dexterlb/wled-i-nator/hardware/wled_controller/wled_controller.kicad_pcb

## KiCad design hardware/wled_controller/wled_controller.kicad_pcb (2024-08-14)

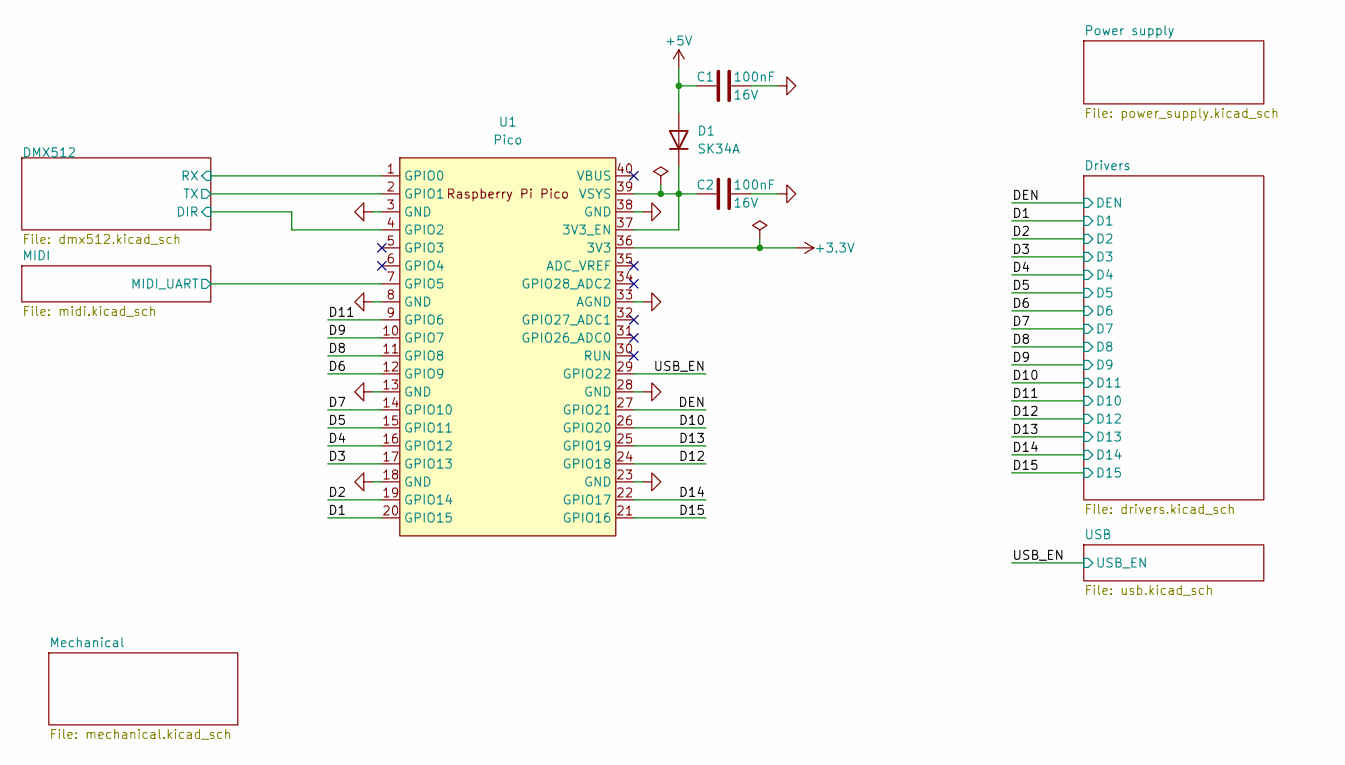
[picture p1: schematic wled_controller.kicad_sch]

Parts:
C1, C2: 100nF; C_0805_2012Metric; Part C 100nF 16V 0805
D1: SK34A; D_SMA; Part SK34A
U1: Pico; RPi_Pico_TH; Part 2x Header_01x20

Connections:
+3.3V: U1.36 (3V3); also elsewhere on the board
+5V: C1.1, D1.2 (A); also elsewhere on the board
/D1: U1.20 (GPIO15); also elsewhere on the board
/D2: U1.19 (GPIO14); also elsewhere on the board
/D3: U1.17 (GPIO13); also elsewhere on the board
/D4: U1.16 (GPIO12); also elsewhere on the board
/D5: U1.15 (GPIO11); also elsewhere on the board
/D6: U1.12 (GPIO9); also elsewhere on the board
/D7: U1.14 (GPIO10); also elsewhere on the board
/D8: U1.11 (GPIO8); also elsewhere on the board
/D9: U1.10 (GPIO7); also elsewhere on the board
/D10: U1.26 (GPIO20); also elsewhere on the board
/D11: U1.9 (GPIO6); also elsewhere on the board
/D12: U1.24 (GPIO18); also elsewhere on the board
/D13: U1.25 (GPIO19); also elsewhere on the board
/D14: U1.22 (GPIO17); also elsewhere on the board
/D15: U1.21 (GPIO16); also elsewhere on the board
/DEN: U1.27 (GPIO21); also elsewhere on the board
/DMX512/DIR: U1.4 (GPIO2); also elsewhere on the board
/DMX512/RX: U1.1 (GPIO0); also elsewhere on the board
/DMX512/TX: U1.2 (GPIO1); also elsewhere on the board
/MIDI/MIDI_UART: U1.7 (GPIO5); also elsewhere on the board
/USB_EN: U1.29 (GPIO22); also elsewhere on the board
GND: C1.2, C2.2, U1.3 (GND), U1.8 (GND), U1.13 (GND), U1.18 (GND), U1.23 (GND), U1.28 (GND), U1.33 (AGND), U1.38 (GND); also elsewhere on the board
unnamed: C2.1, D1.1 (K), U1.37 (3V3_EN), U1.39 (VSYS)

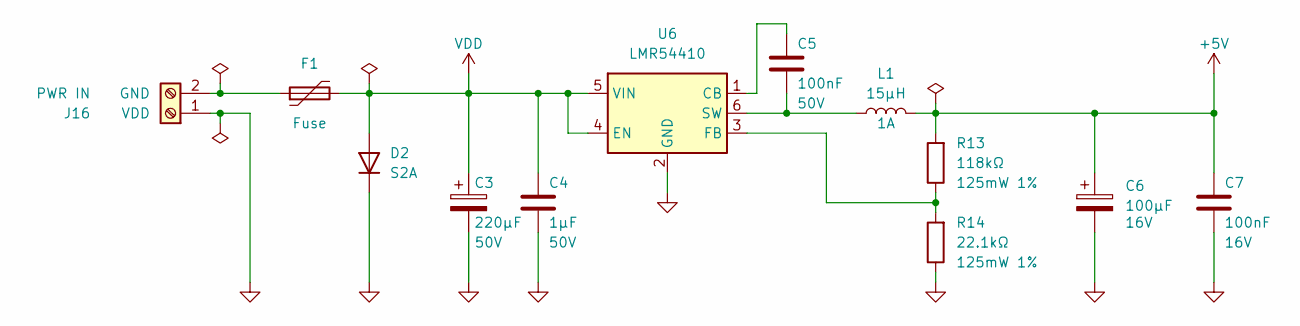
[picture p2: schematic power_supply.kicad_sch]

Parts:
C3: 220μF; CP_Radial_D10.0mm_P5.00mm; Part C 220μF 50V P5
C4: 1μF; C_0805_2012Metric; Part C 1μF 50V 0805
C5: 100nF; C_0805_2012Metric; Part C 100nF 50V 0805
C6: 100μF; CP_Radial_D5.0mm_P2.00mm; Part C 100μF 16V P2
C7: 100nF; C_0805_2012Metric; Part C 100nF 16V 0805
D2: S2A; D_SMB; Part S2A; LCSC C7420368
F1: Fuse; Fuseholder_FS002; Part 2x FS-002
J16: Screw_Terminal_01x02; TerminalBlock_1x02_P5.00mm_Horizontal; Part DG127-5.0-02P-14-00AH
L1: 15μH; L_Changjiang_FNR6045S; Part NRS6045T150MMGK
R13: 118kΩ; R_0805_2012Metric; Part R 118kΩ 125mW 1% 0805
R14: 22.1kΩ; R_0805_2012Metric; Part R 22.1kΩ 125mW 1% 0805
U6: LMR54410; SOT-23-6; Part LMR54410FDBVR

Connections:
+5V: C6.1, C7.1, L1.2, R13.2; also elsewhere on the board
GND: C3.2, C4.2, C6.2, C7.2, D2.1 (K), J16.1, R14.1, U6.2 (GND); also elsewhere on the board
unnamed: F1.1, J16.2
unnamed: C5.1, U6.1 (CB)
unnamed: R13.1, R14.2, U6.3 (FB)
unnamed: C5.2, L1.1, U6.6 (SW)
VDD: C3.1, C4.1, D2.2 (A), F1.2, U6.4 (EN), U6.5 (VIN); also elsewhere on the board

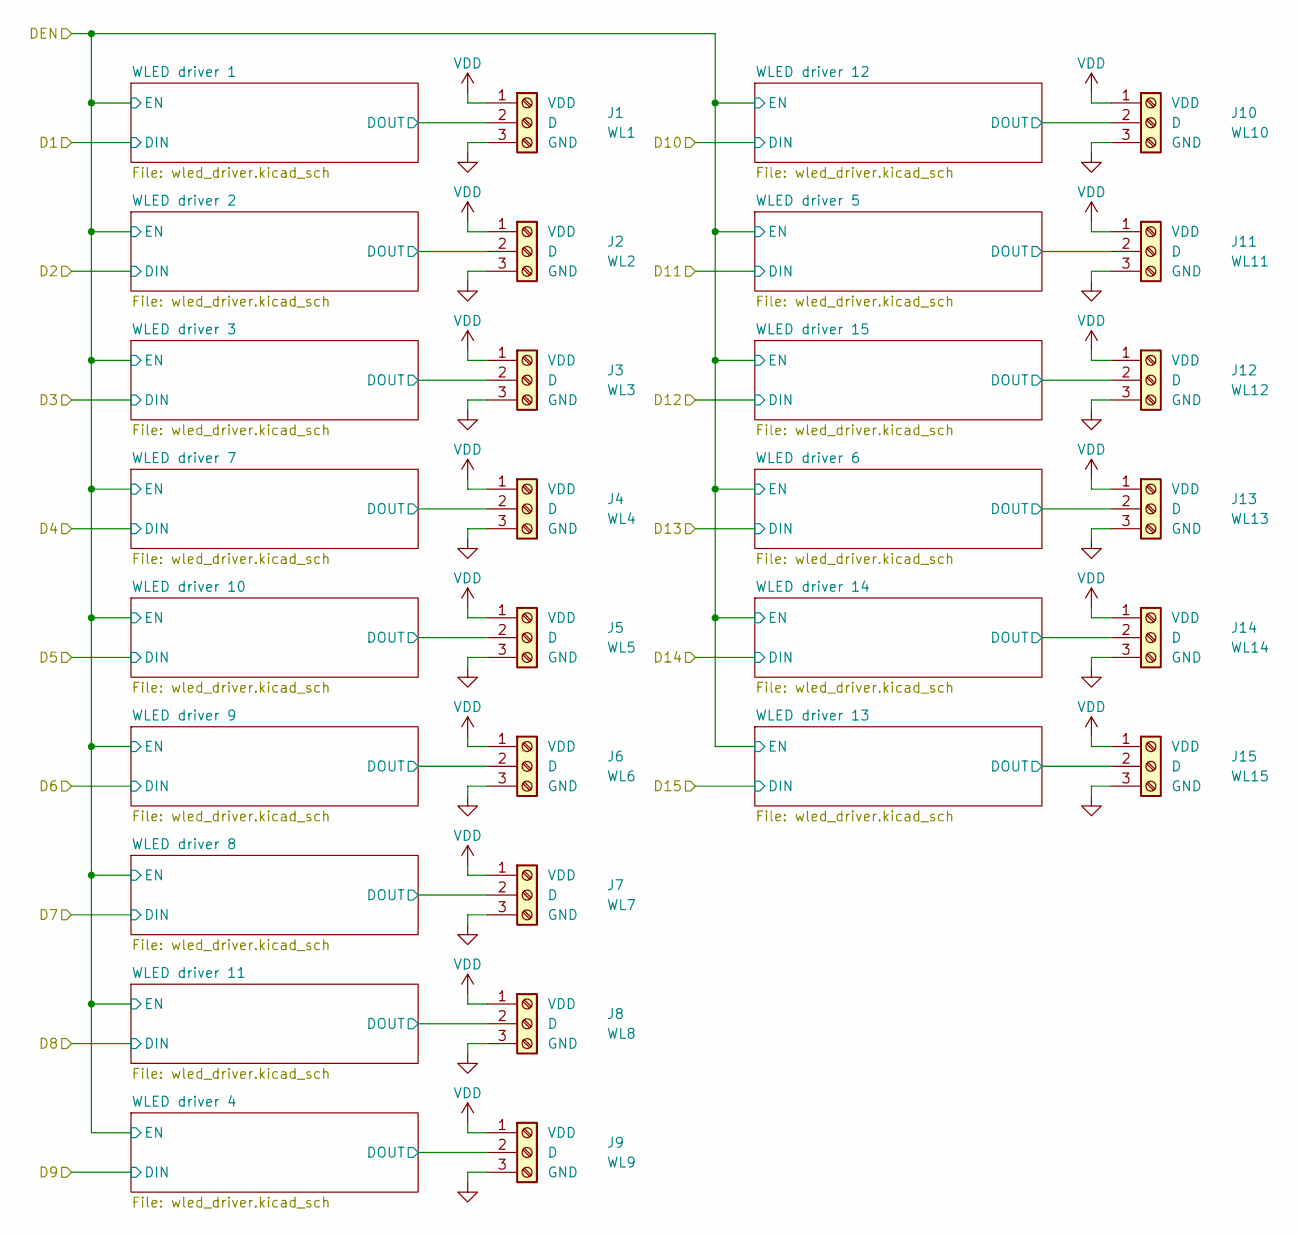
[picture p3: schematic drivers.kicad_sch]

Parts:
J1, J2, J3, J4, J5, J6, J7, J8, J9, J10, J11, J12, J13, J14, J15: Screw_Terminal_01x03; TerminalBlock_Degson_1x03_P3.50mm_Horizontal; Part 15EDGRC-3.5-03P-14-00AH, 15EDGK-3.5-03P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

Connections:
/Drivers/WLED driver 1/DOUT: J1.2; also elsewhere on the board
/Drivers/WLED driver 2/DOUT: J2.2; also elsewhere on the board
/Drivers/WLED driver 3/DOUT: J3.2; also elsewhere on the board
/Drivers/WLED driver 4/DOUT: J9.2; also elsewhere on the board
/Drivers/WLED driver 5/DOUT: J11.2; also elsewhere on the board
/Drivers/WLED driver 6/DOUT: J13.2; also elsewhere on the board
/Drivers/WLED driver 7/DOUT: J4.2; also elsewhere on the board
/Drivers/WLED driver 8/DOUT: J7.2; also elsewhere on the board
/Drivers/WLED driver 9/DOUT: J6.2; also elsewhere on the board
/Drivers/WLED driver 10/DOUT: J5.2; also elsewhere on the board
/Drivers/WLED driver 11/DOUT: J8.2; also elsewhere on the board
/Drivers/WLED driver 12/DOUT: J10.2; also elsewhere on the board
/Drivers/WLED driver 13/DOUT: J15.2; also elsewhere on the board
/Drivers/WLED driver 14/DOUT: J14.2; also elsewhere on the board
/Drivers/WLED driver 15/DOUT: J12.2; also elsewhere on the board
GND: J1.3, J2.3, J3.3, J4.3, J5.3, J6.3, J7.3, J8.3, J9.3, J10.3, J11.3, J12.3, J13.3, J14.3, J15.3; also elsewhere on the board
VDD: J1.1, J2.1, J3.1, J4.1, J5.1, J6.1, J7.1, J8.1, J9.1, J10.1, J11.1, J12.1, J13.1, J14.1, J15.1; also elsewhere on the board

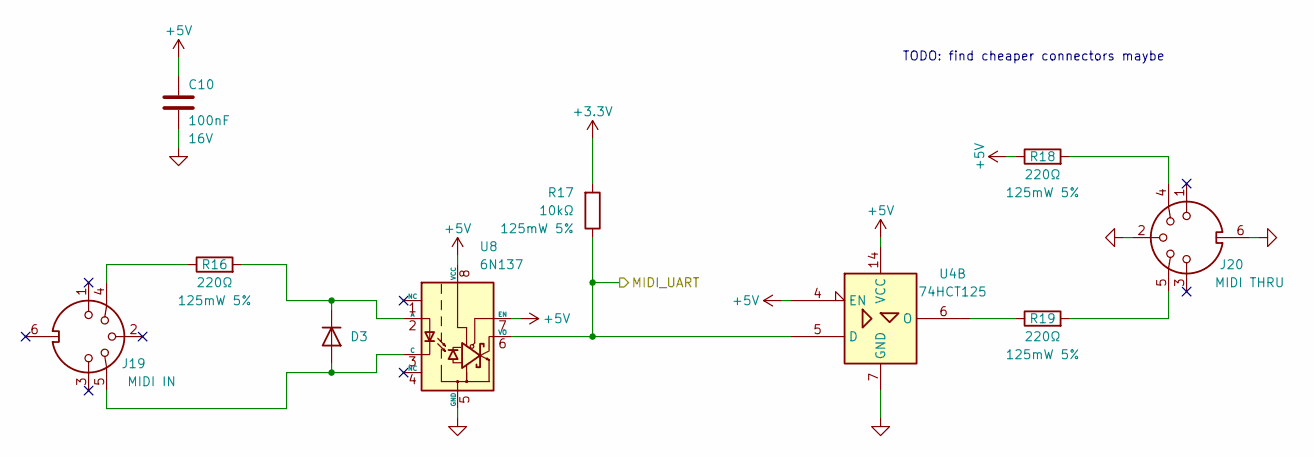
[picture p4: schematic midi.kicad_sch]

Parts:
C10: 100nF; C_0805_2012Metric; Part C 100nF 16V 0805
D3: 1N4148WS; D_SOD-323_HandSoldering; Part 1N4148WS
J19, J20: DIN-5_180degree; DIN5_57PC5F; Part 57PC5F
R16, R18, R19: 220Ω; R_0805_2012Metric; Part R 220Ω 125mW 5% 0805
R17: 10kΩ; R_0805_2012Metric; Part R 10kΩ 125mW 1% 0805
U4: 74HCT125; SO-14_5.3x10.2mm_P1.27mm; Part 74HCT125D
U8: 6N137; SMDIP-8_W9.53mm; Part 6N137S SMD

Connections:
+3.3V: R17.2; also elsewhere on the board
+5V: C10.1, R18.1, U4.4 (EN), U4.14 (VCC), U8.7 (EN), U8.8 (VCC); also elsewhere on the board
/D1: U4.9 (D); also elsewhere on the board
/D3: U4.2 (D); also elsewhere on the board
/DEN: U4.1 (EN), U4.10 (EN); also elsewhere on the board
/MIDI/MIDI_UART: R17.1, U4.5 (D), U8.6 (VO); also elsewhere on the board
GND: C10.2, J20.2, J20.6, U4.7 (GND), U8.5 (GND); also elsewhere on the board
unnamed: D3.2 (A), J19.5, U8.3 (C)
unnamed: D3.1 (K), R16.2, U8.2 (A)
unnamed: J19.4, R16.1
unnamed: J20.4, R18.2
unnamed: J20.5, R19.2
unnamed 65: U4.3 (O); also elsewhere on the board
unnamed: R19.1, U4.6 (O)
unnamed 67: U4.8 (O); also elsewhere on the board

Notes on the sheet:
TODO: find cheaper connectors maybe

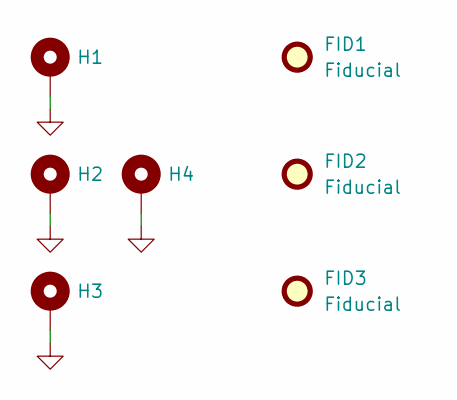
[picture p5: schematic mechanical.kicad_sch]

Parts:
FID1, FID2, FID3: Fiducial; Fiducial_1mm_Mask2mm
H1, H2, H3, H4: MountingHole_Pad; MountingHole_3.2mm_M3_DIN965_Pad

Connections:
GND: H1.1, H2.1, H3.1, H4.1; also elsewhere on the board

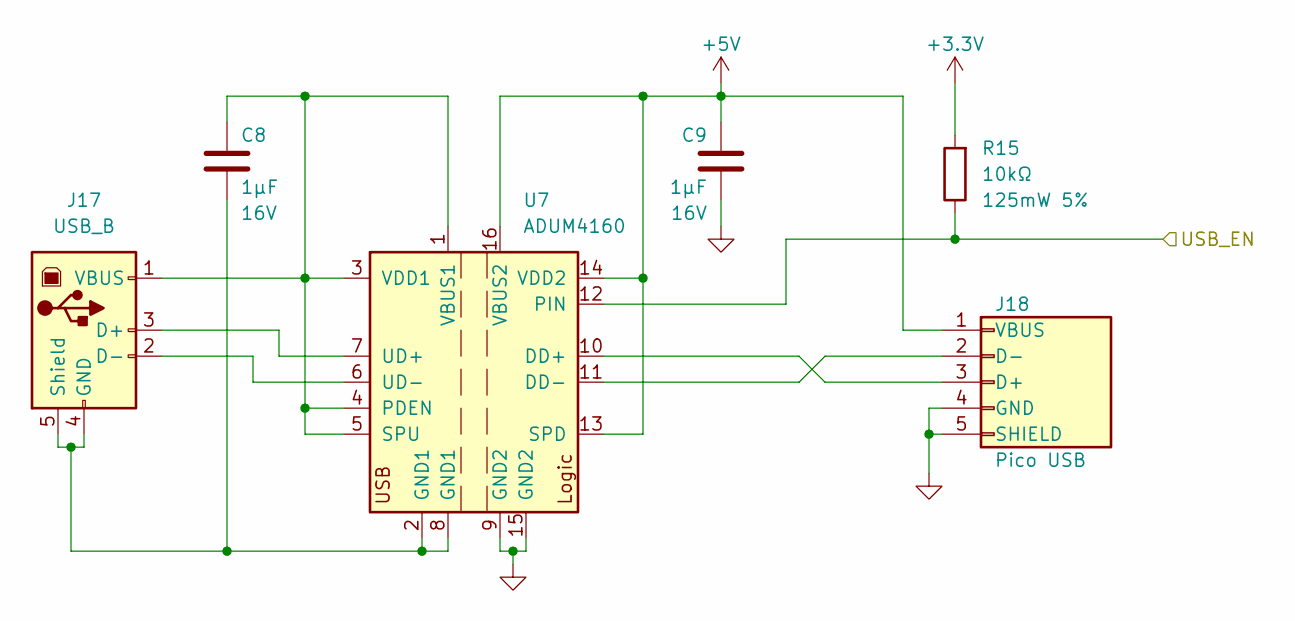
[picture p6: schematic usb.kicad_sch]

Parts:
C8, C9: 1μF; C_0805_2012Metric; Part C 1μF 16V 0805
J17: USB_B; USB_B_Lumberg_2411_02_Horizontal; Part 61729-0010BLF
J18: Header_01x05; PinHeader_1x05_P2.54mm_Vertical; Part Header_01x05
R15: 10kΩ; R_0805_2012Metric; Part R 10kΩ 125mW 1% 0805
U7: ADUM4160; SOIC-16W_7.5x10.3mm_P1.27mm; Part ADUM4160BRWZ

Connections:
+3.3V: R15.2; also elsewhere on the board
+5V: C9.1, J18.1, U7.13 (SPD), U7.14 (VDD2), U7.16 (VBUS2); also elsewhere on the board
/USB_EN: R15.1, U7.12 (PIN); also elsewhere on the board
GND: C9.2, J18.4, J18.5, U7.9 (GND2), U7.15 (GND2); also elsewhere on the board
unnamed: J17.3 (D+), U7.7 (UD+)
unnamed: J17.2 (D-), U7.6 (UD-)
unnamed: C8.2, J17.4 (GND), J17.5 (Shield), U7.2 (GND1), U7.8 (GND1)
unnamed: C8.1, J17.1 (VBUS), U7.1 (VBUS1), U7.3 (VDD1), U7.4 (PDEN), U7.5 (SPU)
unnamed: J18.2, U7.11 (DD-)
unnamed: J18.3, U7.10 (DD+)

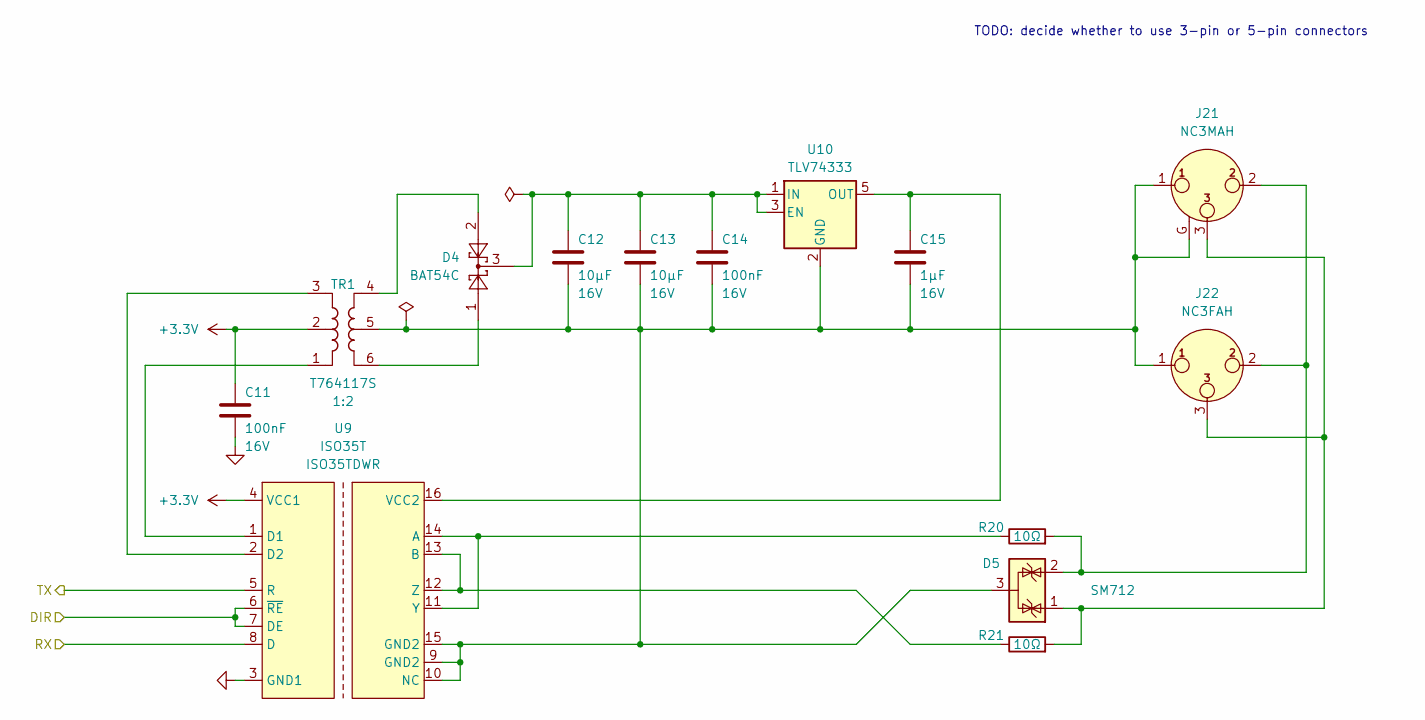
[picture p7: schematic dmx512.kicad_sch]

Parts:
C11, C14: 100nF; C_0805_2012Metric; Part C 100nF 16V 0805
C12, C13: 10μF; C_0805_2012Metric; Part C 10μF 16V 0805
C15: 1μF; C_0805_2012Metric; Part C 1μF 16V 0805
D4: BAT54C; SOT-23; Part BAT54C
D5: SM712; SOT-23
J21: NC3MAH; Jack_XLR_Neutrik_NC3MAH_Horizontal; Part NC3MAH
J22: NC3FAH; Jack_XLR_Neutrik_NC3FAH_Horizontal; Part NC3FAH
R20, R21: 10Ω; R_0805_2012Metric
TR1: T764117S; Bourns_PAD00x-T764; Part PAD001-T764120S
U9: ISO35T; SOIC-16W_7.5x10.3mm_P1.27mm; Part ISO35TDWR
U10: TLV74333; SOT-23-5; Part TLV74333PDBVR

Connections:
+3.3V: C11.1, TR1.2, U9.4 (VCC1); also elsewhere on the board
/DMX512/DIR: U9.6 (~RE), U9.7 (DE); also elsewhere on the board
/DMX512/RX: U9.8 (D); also elsewhere on the board
/DMX512/TX: U9.5 (R); also elsewhere on the board
GND: C11.2, U9.3 (GND1); also elsewhere on the board
unnamed: D4.1, TR1.6
unnamed: D4.2, TR1.4
unnamed: C12.2, C13.2, C14.2, C15.2, D5.3 (A), J21.1, J21.G, J22.1, TR1.5, U9.9 (GND2), U9.10 (NC), U9.15 (GND2), U10.2 (GND)
unnamed: D5.1 (K), J21.3, J22.3, R21.2
unnamed: D5.2 (K), J21.2, J22.2, R20.2
unnamed: R20.1, U9.11 (Y), U9.14 (A)
unnamed: R21.1, U9.12 (Z), U9.13 (B)
unnamed: TR1.1, U9.1 (D1)
unnamed: TR1.3, U9.2 (D2)
unnamed: C12.1, C13.1, C14.1, D4.3, U10.1 (IN), U10.3 (EN)
unnamed: C15.1, U9.16 (VCC2), U10.5 (OUT)

Notes on the sheet:
TODO: decide whether to use 3-pin or 5-pin connectors

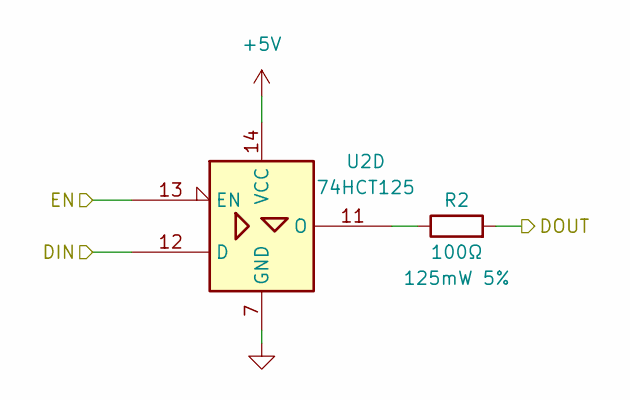
[picture p8: schematic wled_driver.kicad_sch]

Parts:
R2: 100Ω; R_0805_2012Metric; Part RC0805JR-07100RL
U2: 74HCT125; SO-14_5.3x10.2mm_P1.27mm; Part 74HCT125D

Connections:
+5V: U2.14 (VCC); also elsewhere on the board
/D4: U2.9 (D); also elsewhere on the board
/D5: U2.5 (D); also elsewhere on the board
/D6: U2.2 (D); also elsewhere on the board
/D7: U2.12 (D); also elsewhere on the board
/DEN: U2.1 (EN), U2.4 (EN), U2.10 (EN), U2.13 (EN); also elsewhere on the board
/Drivers/WLED driver 8/DOUT: R2.2; also elsewhere on the board
GND: U2.7 (GND); also elsewhere on the board
unnamed 57: U2.3 (O); also elsewhere on the board
unnamed 58: U2.6 (O); also elsewhere on the board
unnamed 59: U2.8 (O); also elsewhere on the board
unnamed: R2.1, U2.11 (O)

Parts of its further copies:
R1, R3, R4, R5, R6, R7, R8, R9, R10, R11, R12, R22, R23, R24: 100Ω; R_0805_2012Metric; Part RC0805JR-07100RL
U3, U5: 74HCT125; SO-14_5.3x10.2mm_P1.27mm; Part 74HCT125D

Connections of its further copies:
+5V: U3.14 (VCC), U5.14 (VCC); also elsewhere on the board
/D8: U3.9 (D); also elsewhere on the board
/D9: U3.5 (D); also elsewhere on the board
/D10: U3.2 (D); also elsewhere on the board
/D11: U3.12 (D); also elsewhere on the board
/D12: U5.9 (D); also elsewhere on the board
/D13: U5.12 (D); also elsewhere on the board
/D14: U5.5 (D); also elsewhere on the board
/D15: U5.2 (D); also elsewhere on the board
/DEN: U3.1 (EN), U3.4 (EN), U3.10 (EN), U3.13 (EN), U5.1 (EN), U5.4 (EN), U5.10 (EN), U5.13 (EN); also elsewhere on the board
/Drivers/WLED driver 1/DOUT: R7.2; also elsewhere on the board
/Drivers/WLED driver 2/DOUT: R8.2; also elsewhere on the board
/Drivers/WLED driver 3/DOUT: R9.2; also elsewhere on the board
/Drivers/WLED driver 4/DOUT: R10.2; also elsewhere on the board
/Drivers/WLED driver 5/DOUT: R11.2; also elsewhere on the board
/Drivers/WLED driver 6/DOUT: R12.2; also elsewhere on the board
/Drivers/WLED driver 7/DOUT: R1.2; also elsewhere on the board
/Drivers/WLED driver 9/DOUT: R3.2; also elsewhere on the board
/Drivers/WLED driver 10/DOUT: R4.2; also elsewhere on the board
/Drivers/WLED driver 11/DOUT: R5.2; also elsewhere on the board
/Drivers/WLED driver 12/DOUT: R6.2; also elsewhere on the board
/Drivers/WLED driver 13/DOUT: R22.2; also elsewhere on the board
/Drivers/WLED driver 14/DOUT: R23.2; also elsewhere on the board
/Drivers/WLED driver 15/DOUT: R24.2; also elsewhere on the board
GND: U3.7 (GND), U5.7 (GND); also elsewhere on the board
unnamed 57: R3.1; also elsewhere on the board
unnamed 58: R4.1; also elsewhere on the board
unnamed 59: R1.1; also elsewhere on the board
unnamed: R11.1, U3.3 (O)
unnamed: R10.1, U3.6 (O)
unnamed: R5.1, U3.8 (O)
unnamed: R6.1, U3.11 (O)
unnamed 65: R9.1; also elsewhere on the board
unnamed 67: R7.1; also elsewhere on the board
unnamed 68: R8.1; also elsewhere on the board
unnamed: R22.1, U5.3 (O)
unnamed: R23.1, U5.6 (O)
unnamed: R24.1, U5.8 (O)
unnamed: R12.1, U5.11 (O)

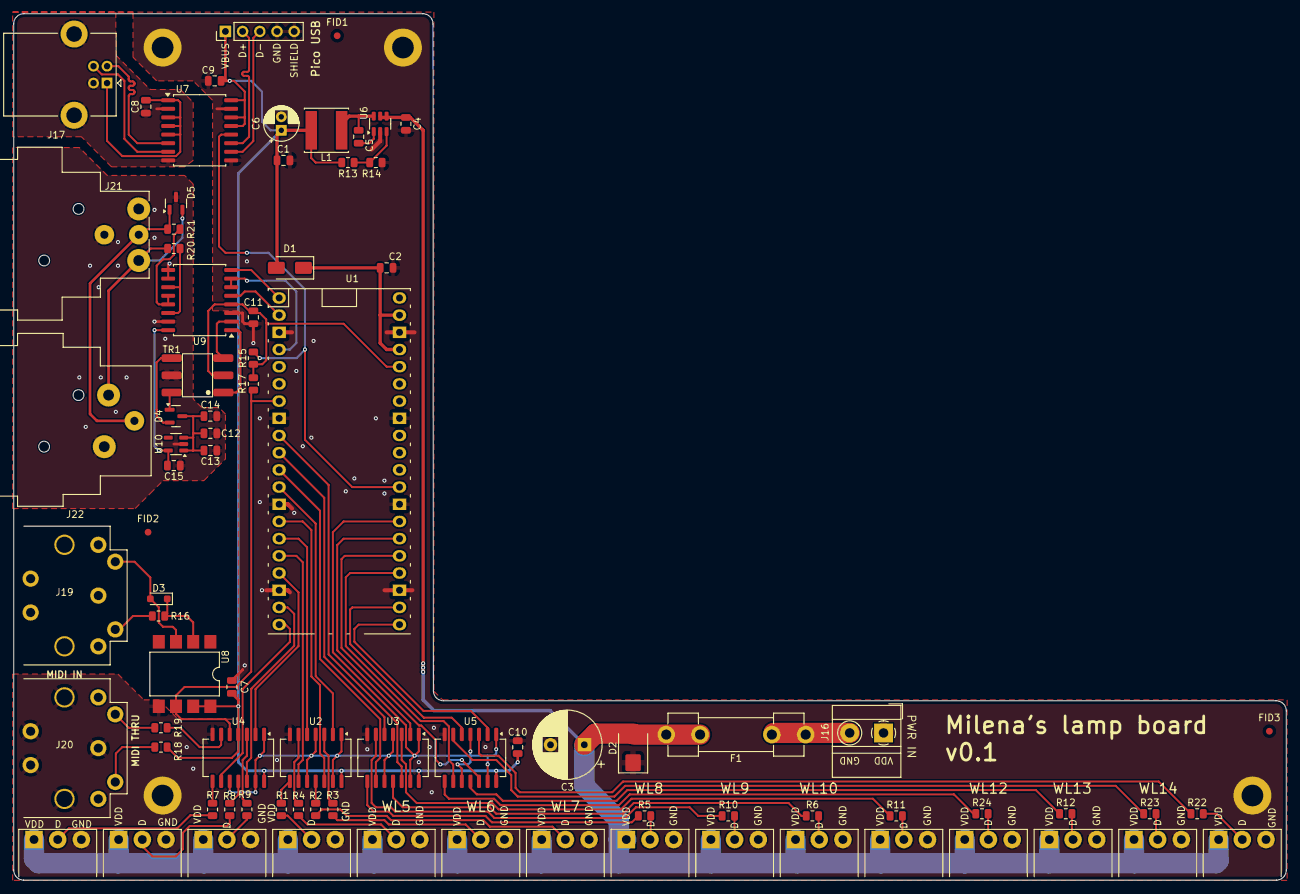
[picture p9: board wled_controller.kicad_pcb from above]

Board: 2 copper layers, 188.0 x 128.0 mm, 86 parts (0 on the bottom side), 83 nets.
