dexterlb/wled-i-nator/(commit log)

2024-08-09 add pcb
    [dmx512.kicad_sch, drivers.kicad_sch, midi.kicad_sch, power_supply.kicad_sch, usb.kicad_sch, wled_controller.kicad_pcb, wled_controller.kicad_sch, wled_driver.kicad_sch]
2024-08-09 finalise schematic
    [dmx512.kicad_sch, drivers.kicad_sch, midi.kicad_sch, power_supply.kicad_sch, usb.kicad_sch, wled_controller.kicad_pcb, wled_controller.kicad_sch, wled_driver.kicad_sch]
2024-08-12 some progress on PCB
    [dmx512.kicad_sch, drivers.kicad_sch, mechanical.kicad_sch, midi.kicad_sch, power_supply.kicad_sch, usb.kicad_sch, wled_controller.kicad_pcb, wled_controller.kicad_sch]
2024-08-14 work on pcb
    [dmx512.kicad_sch, drivers.kicad_sch, mechanical.kicad_sch, midi.kicad_sch, power_supply.kicad_sch, usb.kicad_sch, wled_controller.kicad_pcb, wled_controller.kicad_sch]
2024-08-14 dmx512 line TVS
    [dmx512.kicad_sch, mechanical.kicad_sch, midi.kicad_sch, usb.kicad_sch, wled_controller.kicad_pcb, wled_driver.kicad_sch]
2024-08-14 final pcb touches
    [wled_controller.kicad_pcb]
2024-08-26 update bom
    [dmx512.kicad_sch, midi.kicad_sch, usb.kicad_sch, wled_controller.kicad_sch]
